Qaisar-baloch/remote-sensing-communication-cansat/hardware/subsystem-schematics/recovery.png

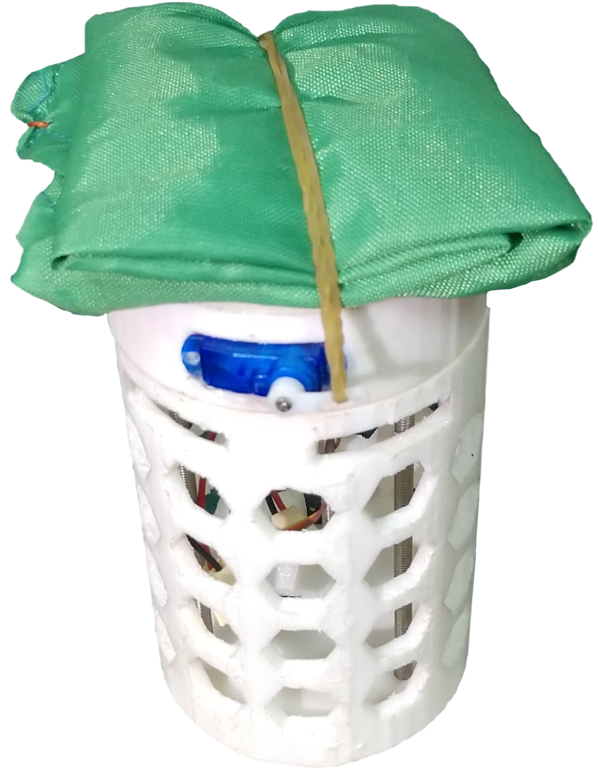
hardware/subsystem-schematics/recovery.png
