Qaisar-baloch/remote-sensing-communication-cansat/hardware/subsystem-schematics/CAMERA.png

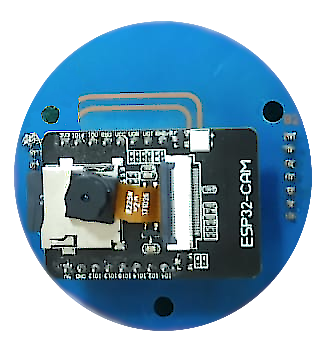
hardware/subsystem-schematics/CAMERA.png
