Qaisar-baloch/remote-sensing-communication-cansat/docs/certificates/best_project_award.pdf

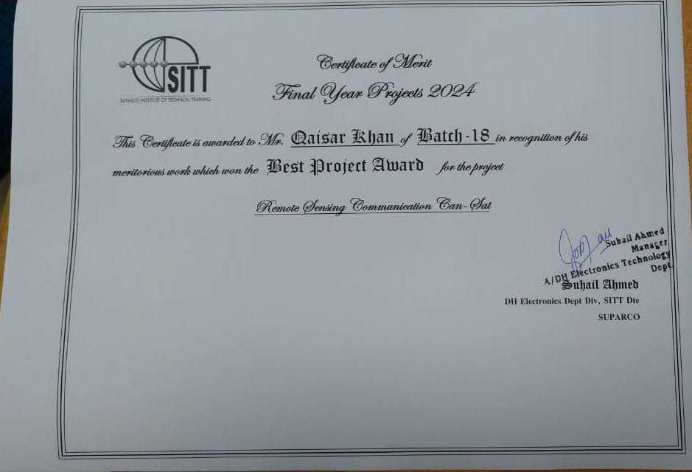
[picture p78: figure]

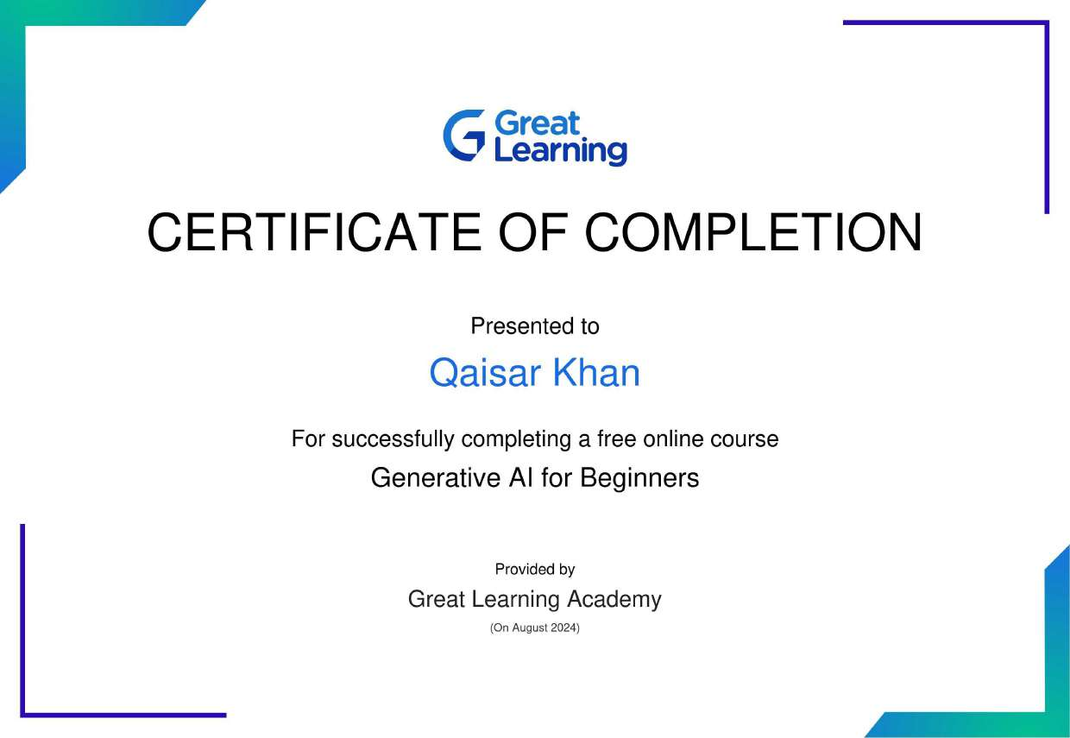
[picture p79: figure]

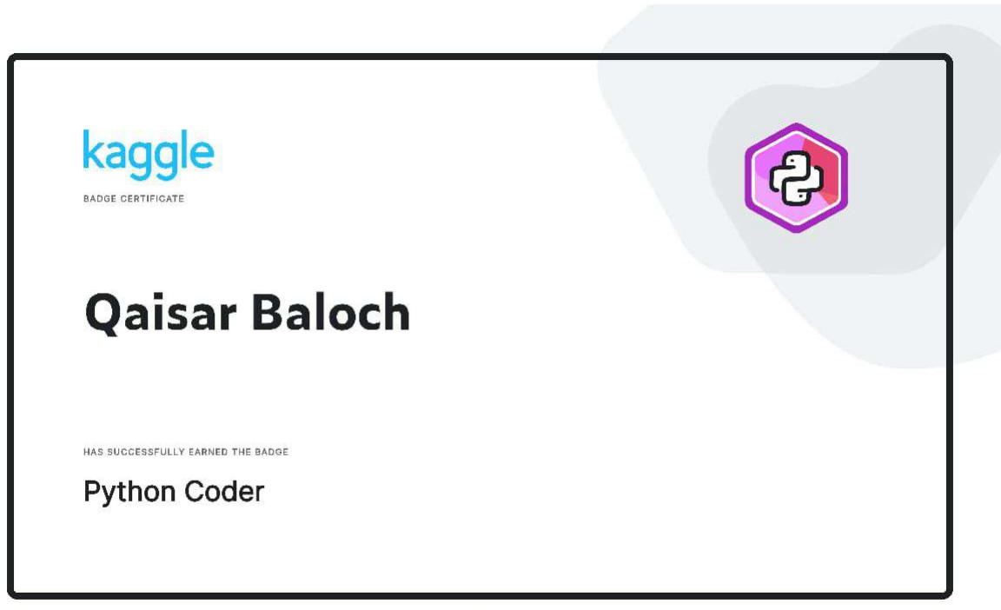
[picture p80: figure]
