Qaisar-baloch/remote-sensing-communication-cansat/Cansat final images/comparison2.jpg

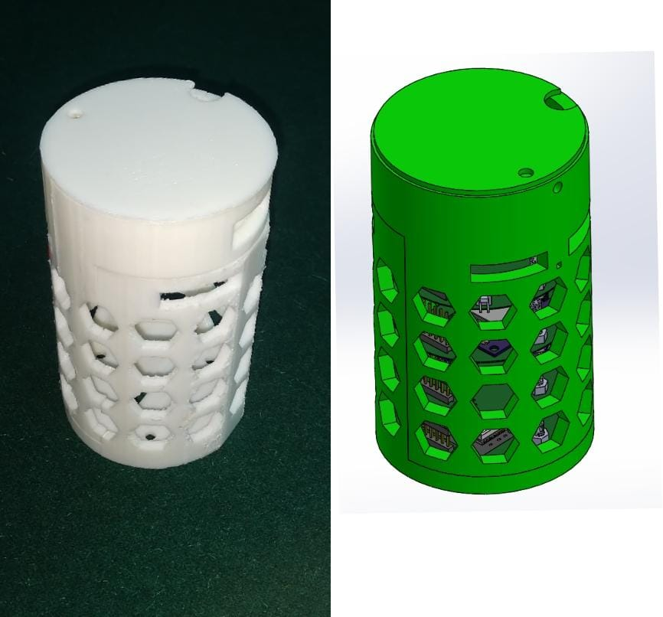
Cansat final images/comparison2.jpg
