Qaisar-baloch/remote-sensing-communication-cansat/Cansat final images/final1.JPG

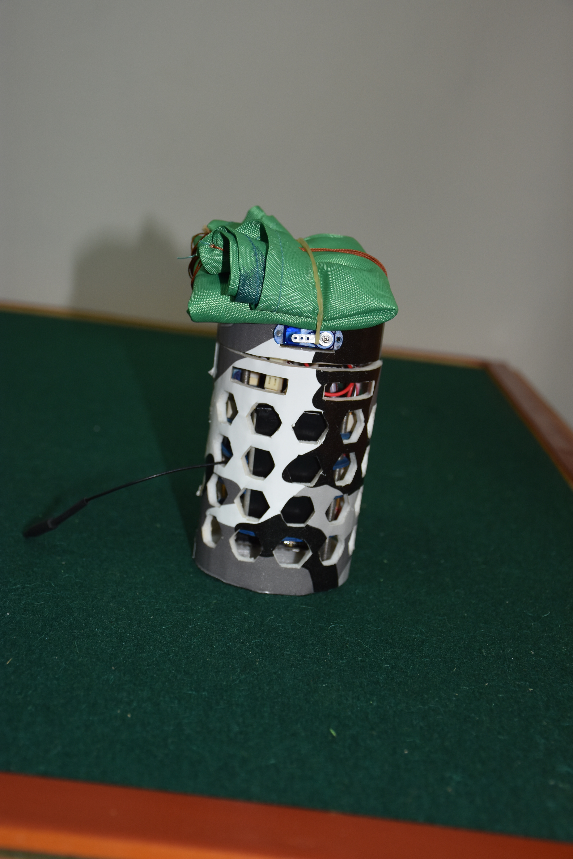
Cansat final images/final1.JPG
