Qaisar-baloch/remote-sensing-communication-cansat/Cansat final images/open2.jpg

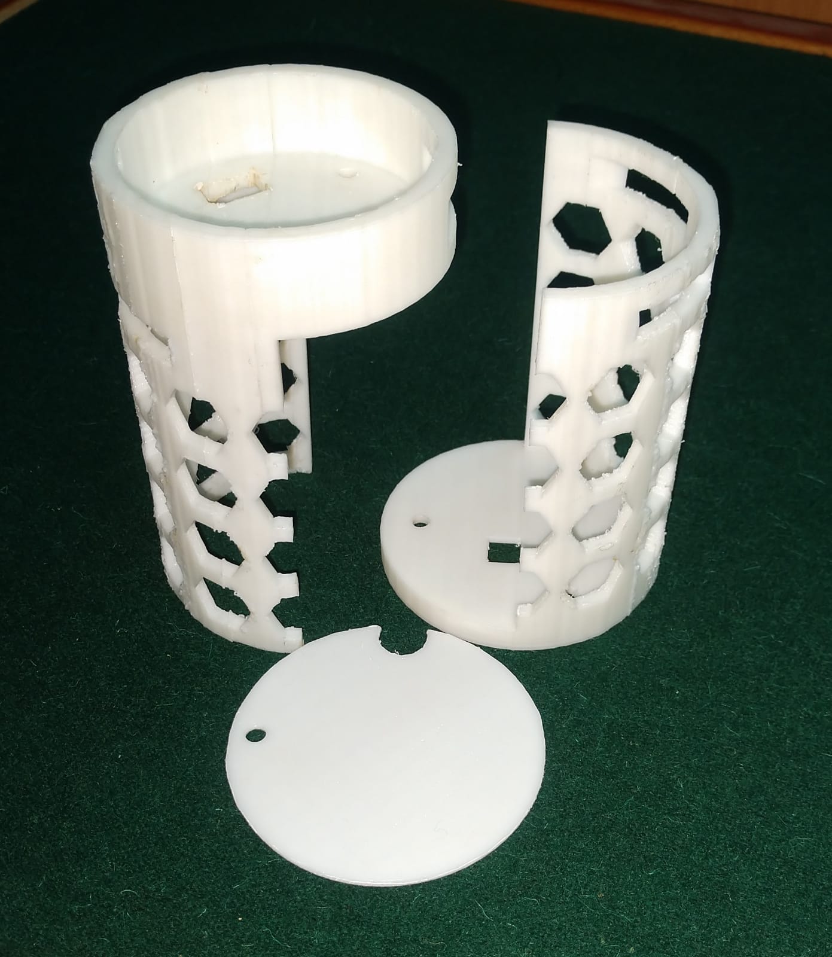
Cansat final images/open2.jpg
