Qaisar-baloch/remote-sensing-communication-cansat/Cansat final images/side view.jpg

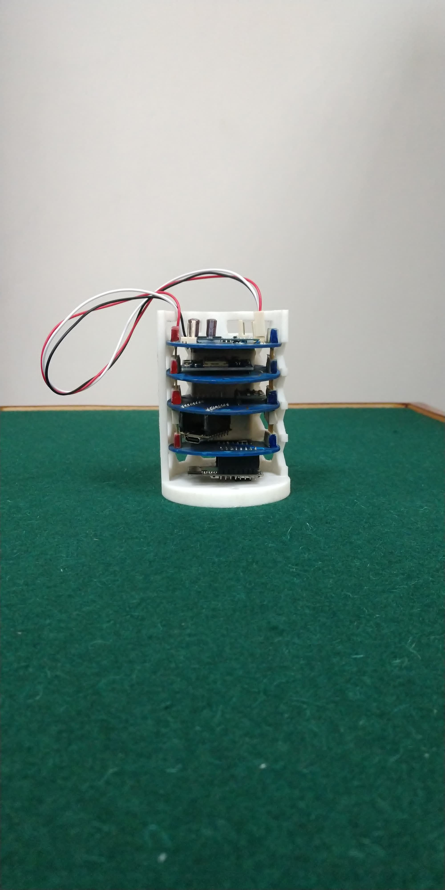
Cansat final images/side view.jpg
