Qaisar-baloch/remote-sensing-communication-cansat/Cansat final images/subsystems interfaced.jpg

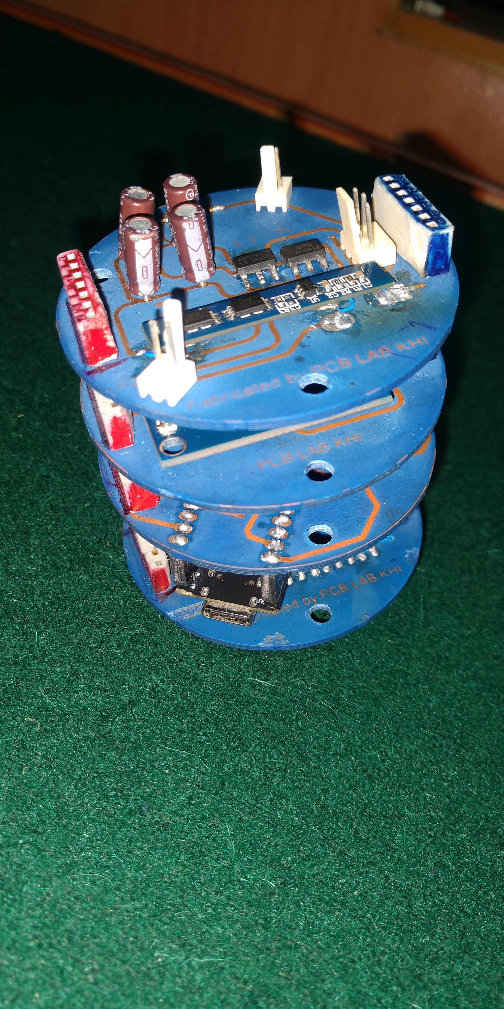
Cansat final images/subsystems interfaced.jpg
