Qaisar-baloch/remote-sensing-communication-cansat/Cansat final images/subsystems.jpg

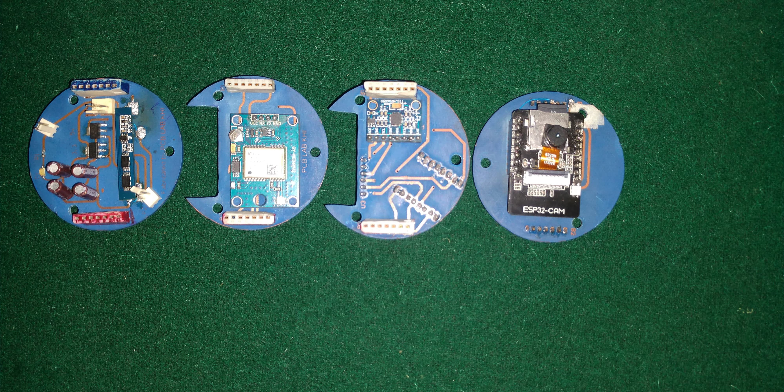
Cansat final images/subsystems.jpg
