Qaisar-baloch/remote-sensing-communication-cansat/hardware/subsystem-schematics/cansat.png

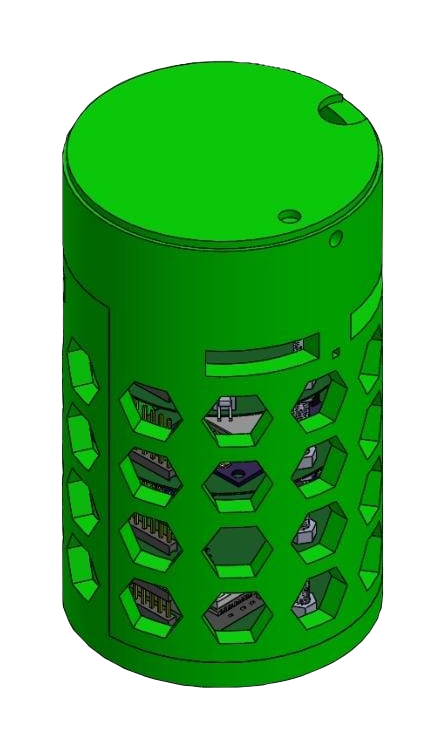
hardware/subsystem-schematics/cansat.png
