Qaisar-baloch/remote-sensing-communication-cansat/hardware/subsystem-schematics/COMM.png

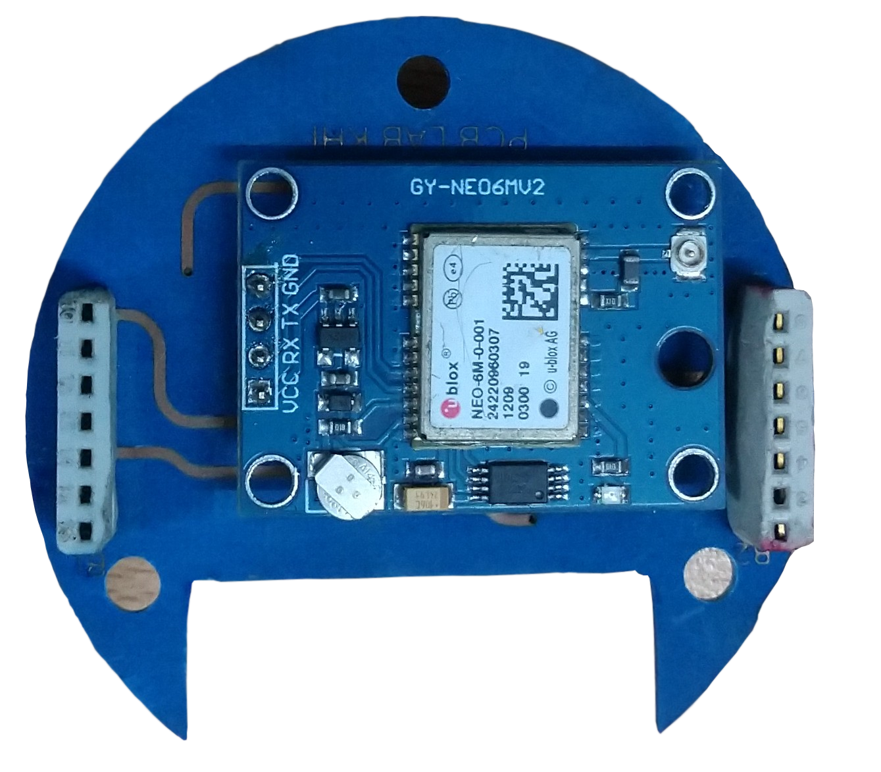
hardware/subsystem-schematics/COMM.png
