Qaisar-baloch/remote-sensing-communication-cansat/hardware/subsystem-schematics/GCS.png

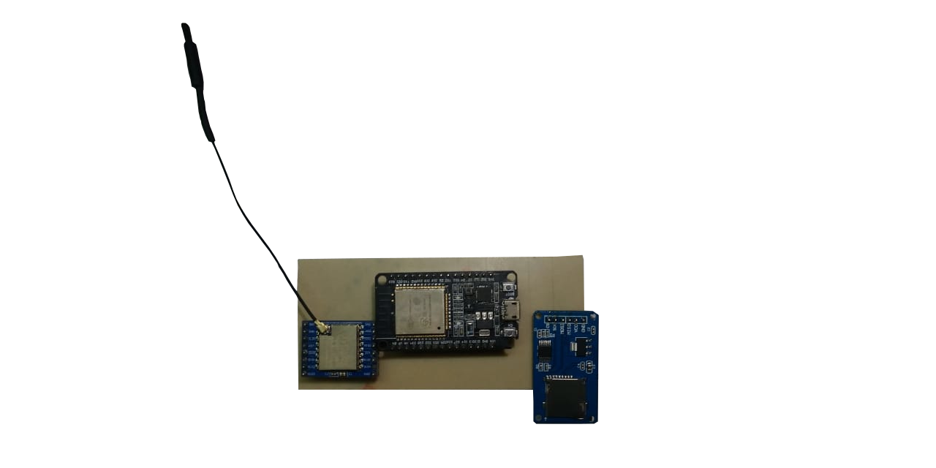
hardware/subsystem-schematics/GCS.png
