Qaisar-baloch/remote-sensing-communication-cansat/hardware/subsystem-schematics/power.png

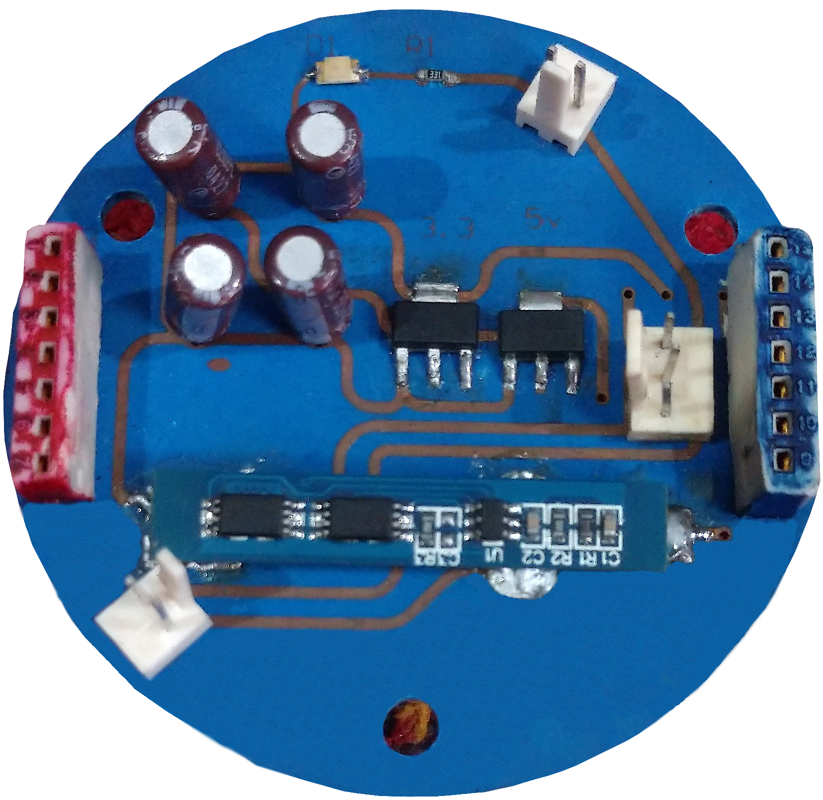
hardware/subsystem-schematics/power.png
