Qaisar-baloch/remote-sensing-communication-cansat/hardware/subsystem-schematics/SENSOR.png

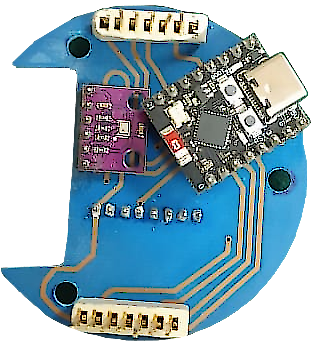
hardware/subsystem-schematics/SENSOR.png
