Qaisar-baloch/remote-sensing-communication-cansat/hardware/subsystem-schematics/Structure.png

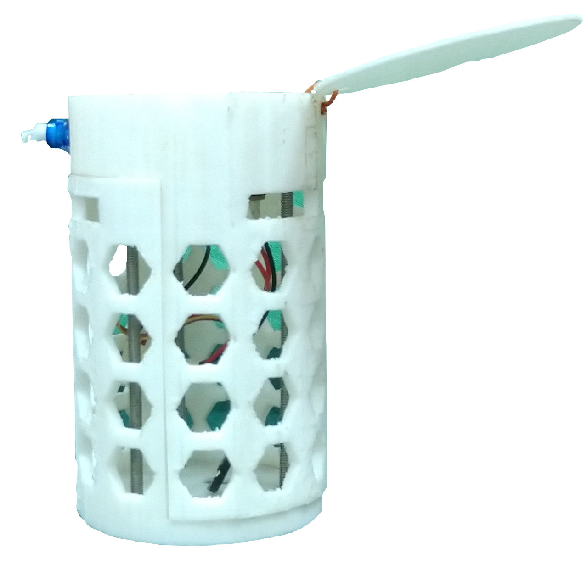
hardware/subsystem-schematics/Structure.png
