Qaisar-baloch/remote-sensing-communication-cansat/hardware/subsystem-schematics/SUBSYSTEMS.png

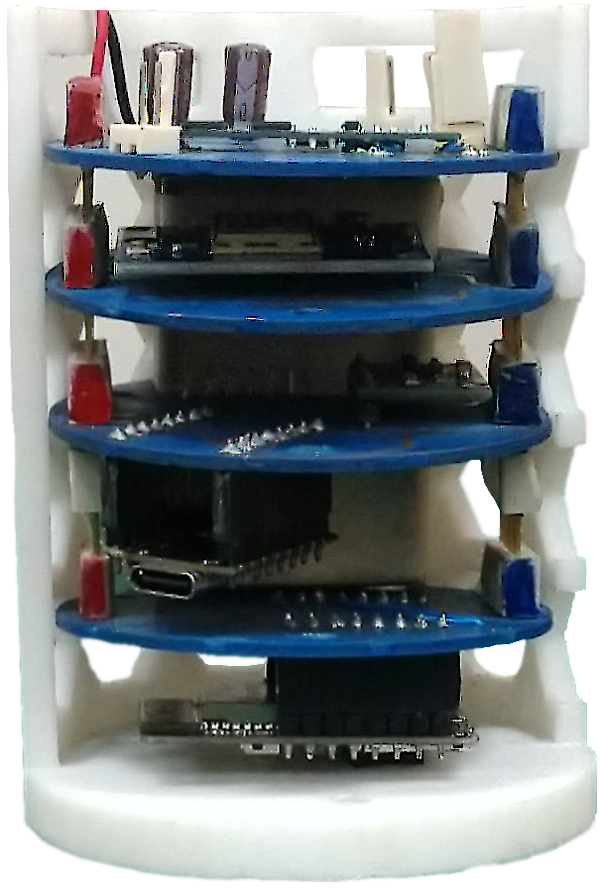
hardware/subsystem-schematics/SUBSYSTEMS.png
