Qaisar-baloch/remote-sensing-communication-cansat/media/certificates/best_project_award_SITT.jpg

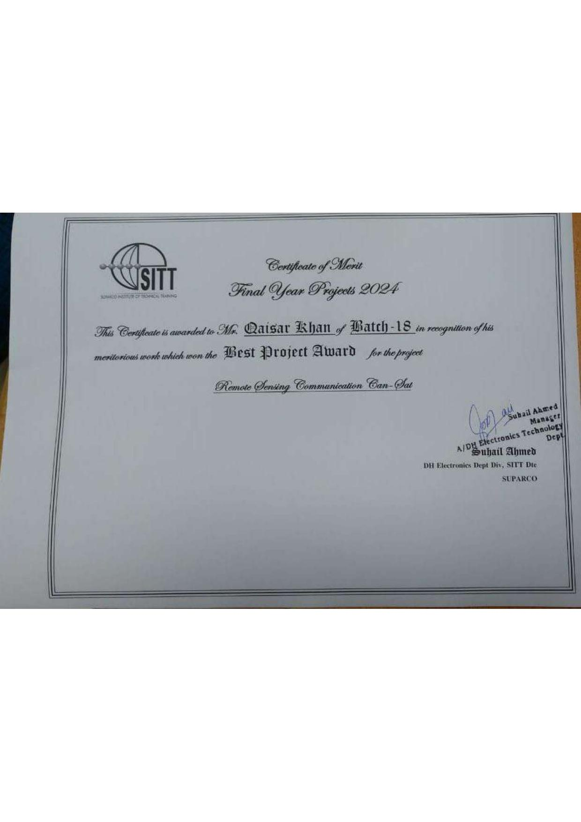
media/certificates/best_project_award_SITT.jpg
