Qaisar-baloch/remote-sensing-communication-cansat/media/certificates/iran_cansat_2nd_place.jpg

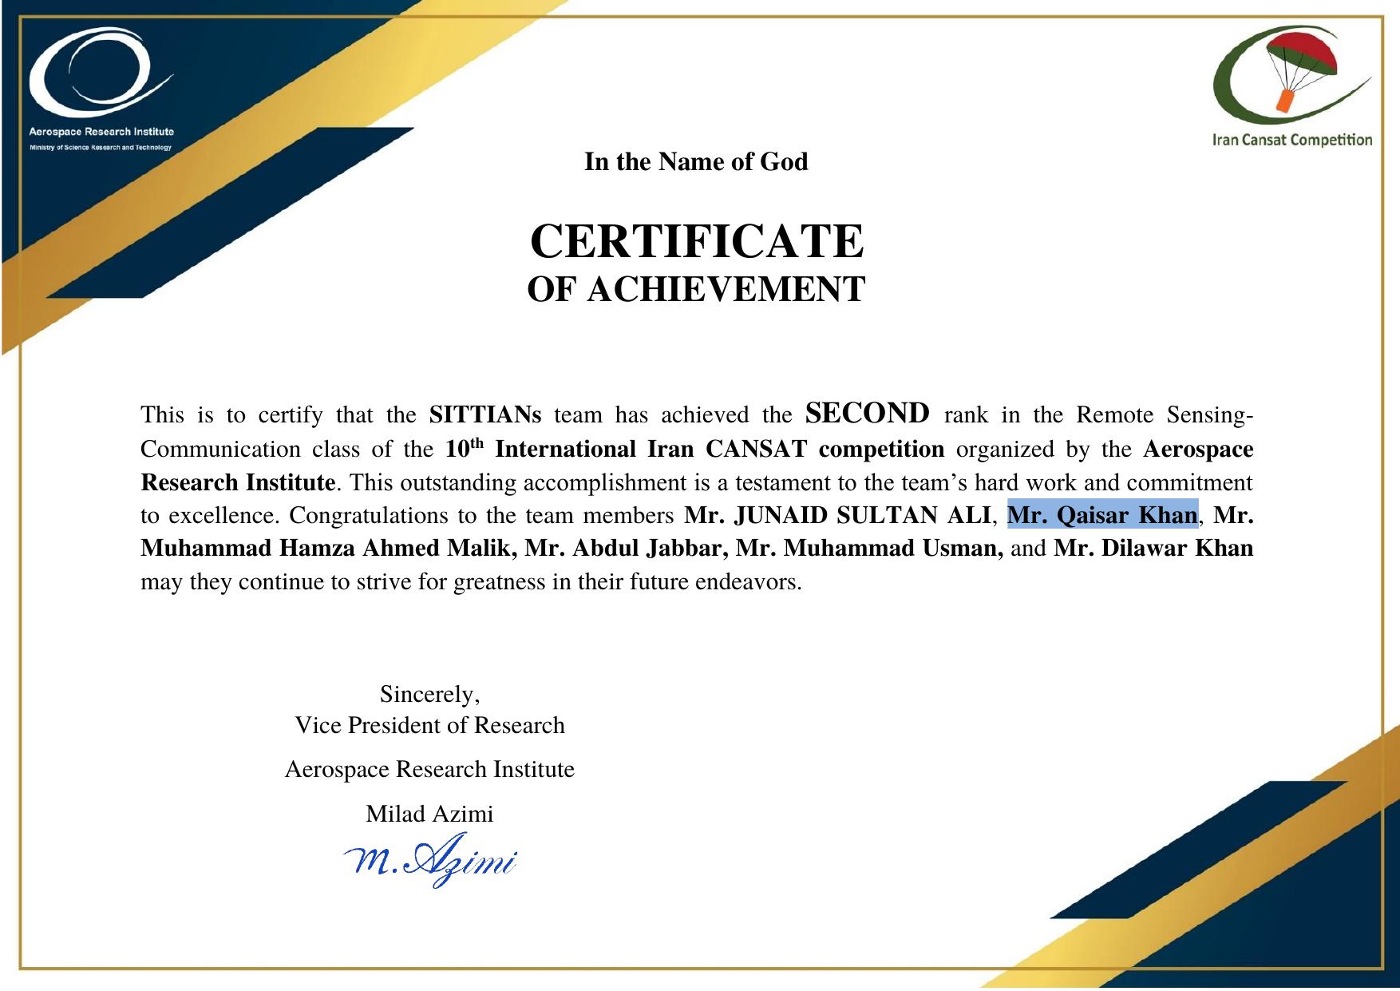
media/certificates/iran_cansat_2nd_place.jpg
