Qaisar-baloch/remote-sensing-communication-cansat/(list of files, drawings)

Other design files:
hardware/pcb/CANSAT_COMMUNICATION/CANSAT_PCB_COMM.PrjPcb
hardware/pcb/CANSAT_COMMUNICATION/PCB_COMM.PcbDoc
hardware/pcb/CANSAT_COMMUNICATION/SCHEMATIC_COMM.SchDoc
hardware/pcb/CANSAT_CONTROLLER/cansat controller.PrjPcb
hardware/pcb/CANSAT_CONTROLLER/PCB1.PcbDoc
hardware/pcb/CANSAT_CONTROLLER/Sheet2.SchDoc
hardware/pcb/CANSAT_EPS/AZ1117EH-5.0TRG1/AZ1117EH-5.0TRG1.SchLib
hardware/pcb/CANSAT_EPS/AZ1117EH-5.0TRG1/SOT230P700X180-4N.PcbLib
hardware/pcb/CANSAT_EPS/BMS 2S.PcbLib
hardware/pcb/CANSAT_EPS/BMS 2S.SchLib
hardware/pcb/CANSAT_EPS/CANSAT_EPS.PrjPcb
hardware/pcb/CANSAT_EPS/EPS/CANSAT_EPS.PrjPcb
hardware/pcb/CANSAT_EPS/EPS/PCB1.PcbDoc
hardware/pcb/CANSAT_EPS/EPS/PcbLib1.PcbLib
hardware/pcb/CANSAT_EPS/EPS/Schlib1.SchLib
hardware/pcb/CANSAT_EPS/EPS/Sheet1.SchDoc
hardware/pcb/CANSAT_EPS/SOT230P700X185-4N.PcbLib
hardware/pcb/CANSAT_SENSOR/SENSOR/PCB2.PcbDoc
hardware/pcb/CANSAT_SENSOR/SENSOR/SENSOR.PrjPcb
hardware/pcb/CANSAT_SENSOR/SENSOR/Sheet2.SchDoc
