Qaisar-baloch/remote-sensing-communication-cansat/Cansat final images/final2.JPG

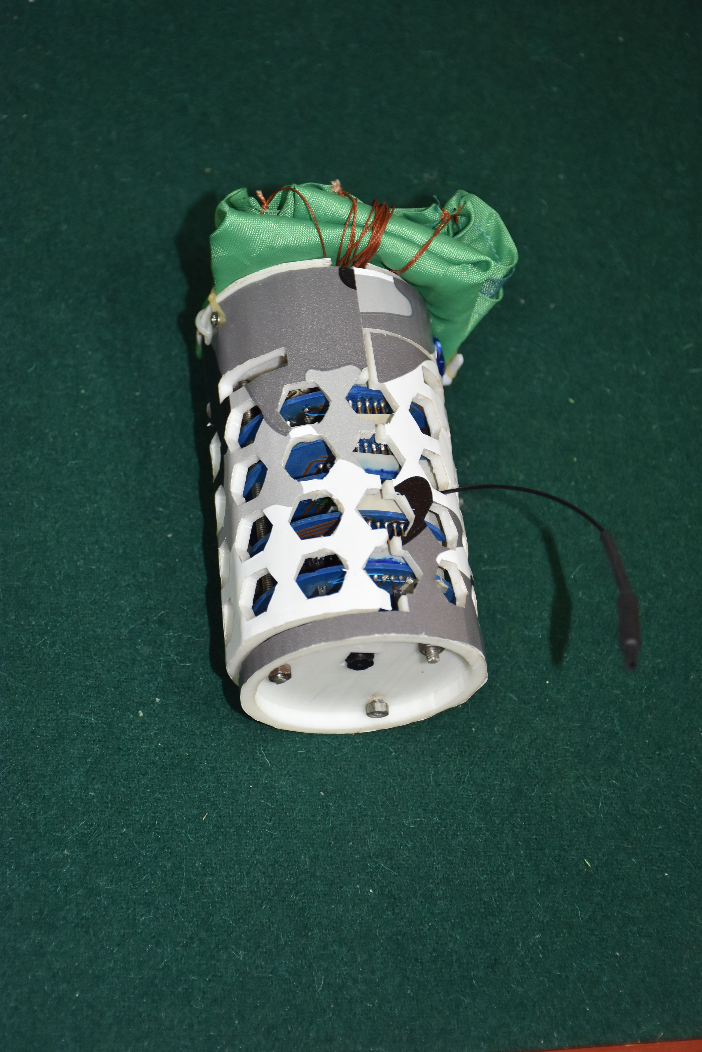
Cansat final images/final2.JPG
