Qaisar-baloch/remote-sensing-communication-cansat/Cansat final images/open1.JPG

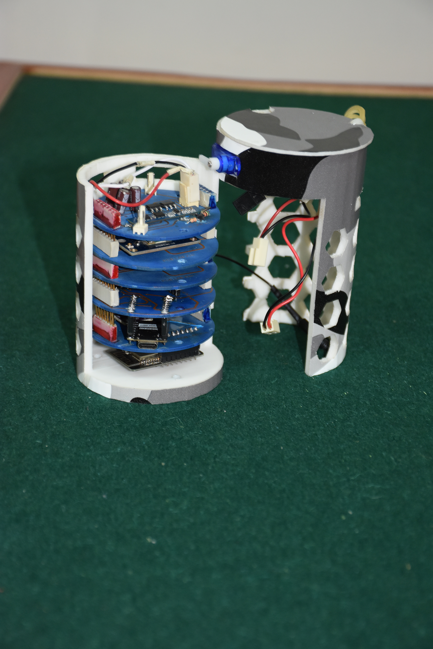
Cansat final images/open1.JPG
